Ahad732/PetCam/Hardware/production/bom.csv

Designator | Footprint | Quantity | Value | LCSC Part #
C1, C2 | 0402 | 2 | 10u
C3 | 0402 | 1 | 0.1u
D1 | 0402 | 1 | RED
D2 | 0402 | 1 | GREEN
J1 | PinSocket_2x09_P2.54mm_Vertical | 1 | Camera
J2 | USB_C_Receptacle_HCTL_HC-TYPE-C-16P-01A | 1 | USB_C_Receptacle_USB2.0_16P
J3 | microSD_HC_Molex_104031-0811 | 1 | Micro_SD_Card
J4 | PinSocket_1x02_P2.54mm_Vertical | 1 | Battery
J5, J6 | PinSocket_1x02_P2.54mm_Vertical | 2 | Conn_01x02_Pin
L1 | L_Vishay_IFSC-1515AH_4x4x1.8mm | 1 | 2.2u
R1, R2 | 0402 | 2 | 5.1k
R10, R11, R8 | 0402 | 3 | 1k
R3, R7 | 0402 | 2 | 10k
R4 | 0402 | 1 | 430k
R5 | 0402 | 1 | 100k
R6 | 0402 | 1 | 100
R9 | 0402 | 1 | 600
SW1 | SW_SPST_PTS810 | 1 | SW_Push
U1 | ESP32-S3-WROOM-1 | 1 | ESP32-S3-WROOM-1
U2 | VQFN-16-1EP_3x3mm_P0.5mm_EP1.6x1.6mm | 1 | BQ24072RGT
U3 | SOT-23-5 | 1 | TLV62568DBV
