Ahad732/PetCam/3d/case.step

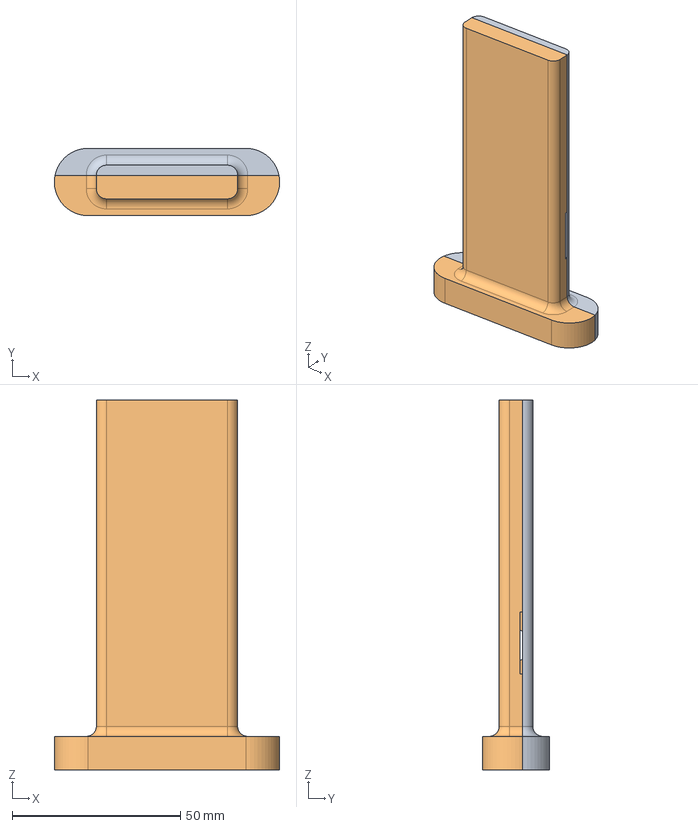
[picture p8: CAD file, 2026-11-08]
3d/case.step
67.0 x 20.0 x 110.0 mm
