Ahad732/PetCam/3d/Camera_OV5640_130deg.step

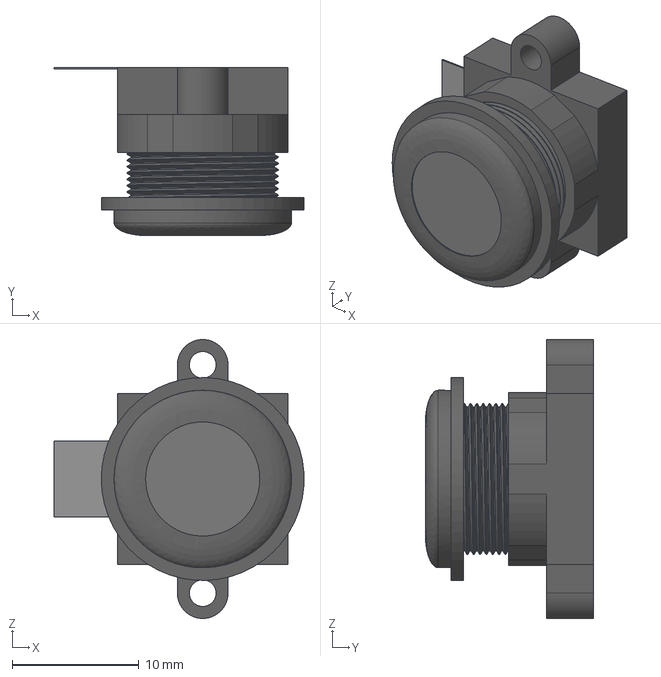
[picture p9: CAD file, 2026-11-08]
3d/Camera_OV5640_130deg.step
19.7 x 13.3 x 22.0 mm
