Ahad732/PetCam/3d/pcb.step

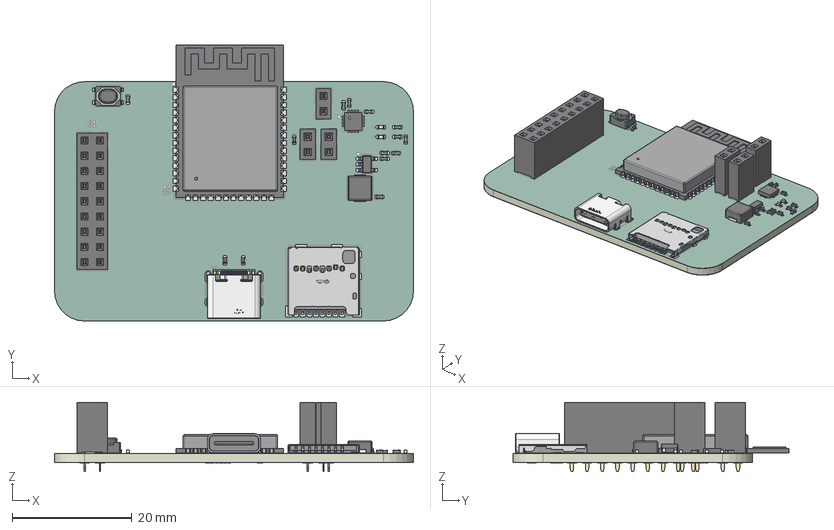
[picture p10: CAD file, 2026-11-08]
3d/pcb.step
60.0 x 46.1 x 11.6 mm
C_0402_1005Metric x 3
L_0402_1005Metric x 8
PinSocket_1x02_P2.54mm_Vertical x 3
R_0402_1005Metric x 3
SIM-SMD_8P-1040310811
LED_0402_1005Metric x 2
L_Vishay_IHLP-1616
TQFN_16_1EP_3x3mm_P05mm_EP16x16mm
SOT-23-5
SW_SPST_PTS810
USB-C-SMD_TYPE-C16PIN
PinSocket_2x09_P2.54mm_Vertical
ESP32-S3-WROOM-1
Pet2C7D_pad
Pet2C7D_silkscreen x 2
Pet2C7D_soldermask x 2
Pet2C7D_PCB
