Ahad732/PetCam/(list of files, cad)

Other CAD files:
3d/petcam-assembly.step
3d/case_printable.stl
