Ahad732/PetCam/media/schematic.pdf

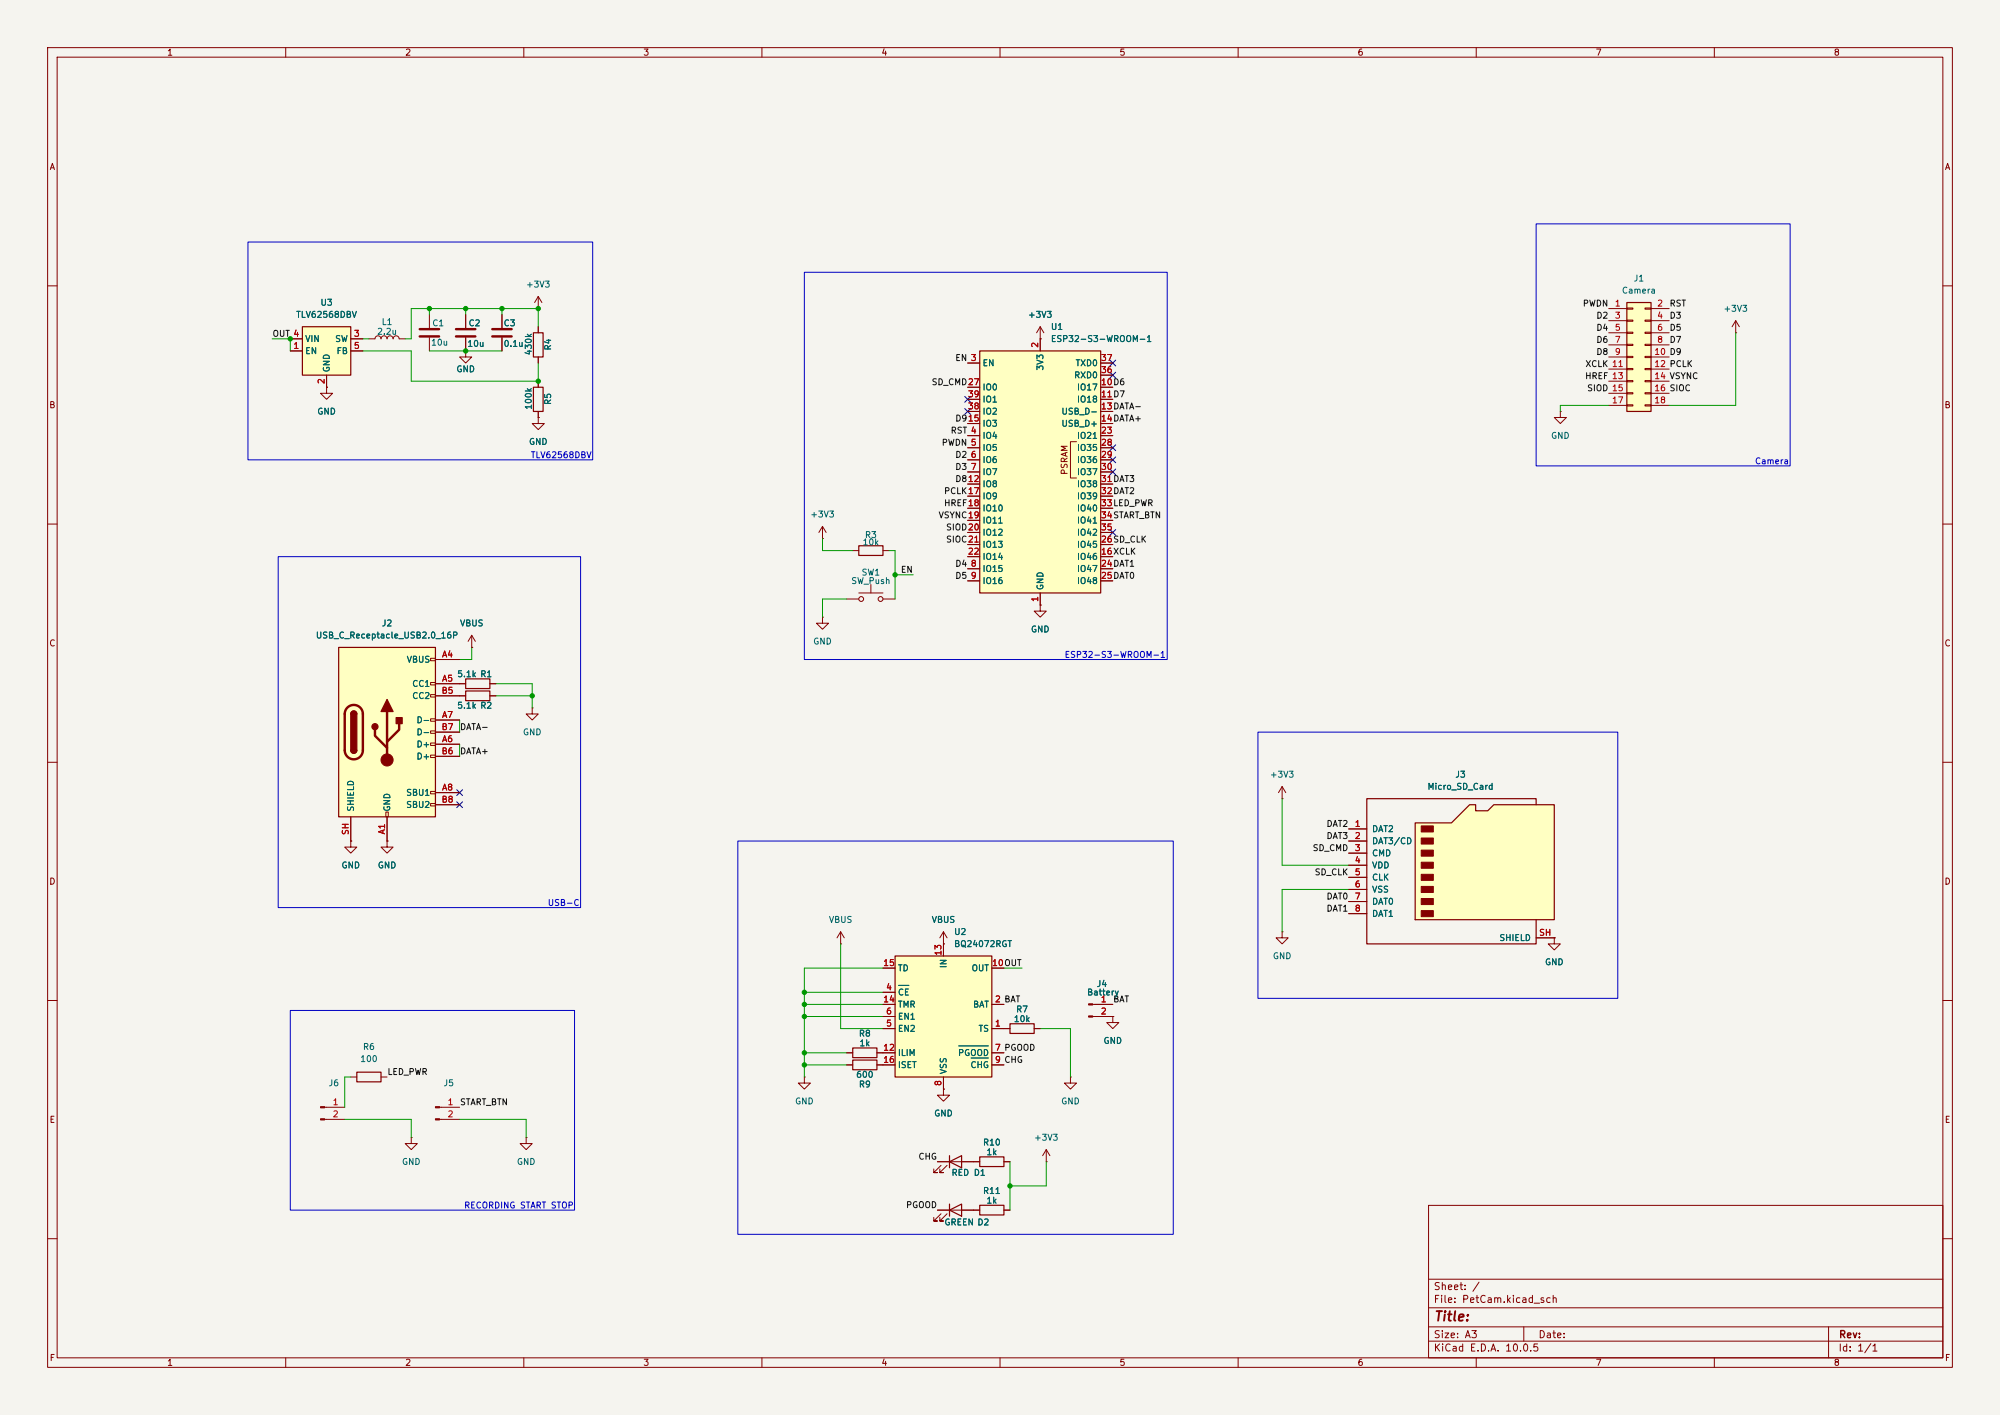
[picture p11: page 1]

Size: A3 | Rev:
KiCad E.D.A. 10.0.5 | Id: 1/1
