Ahad732/PetCam/Hardware/PetCam.kicad_pcb

## KiCad design Hardware/PetCam.kicad_pcb (2026-11-08)

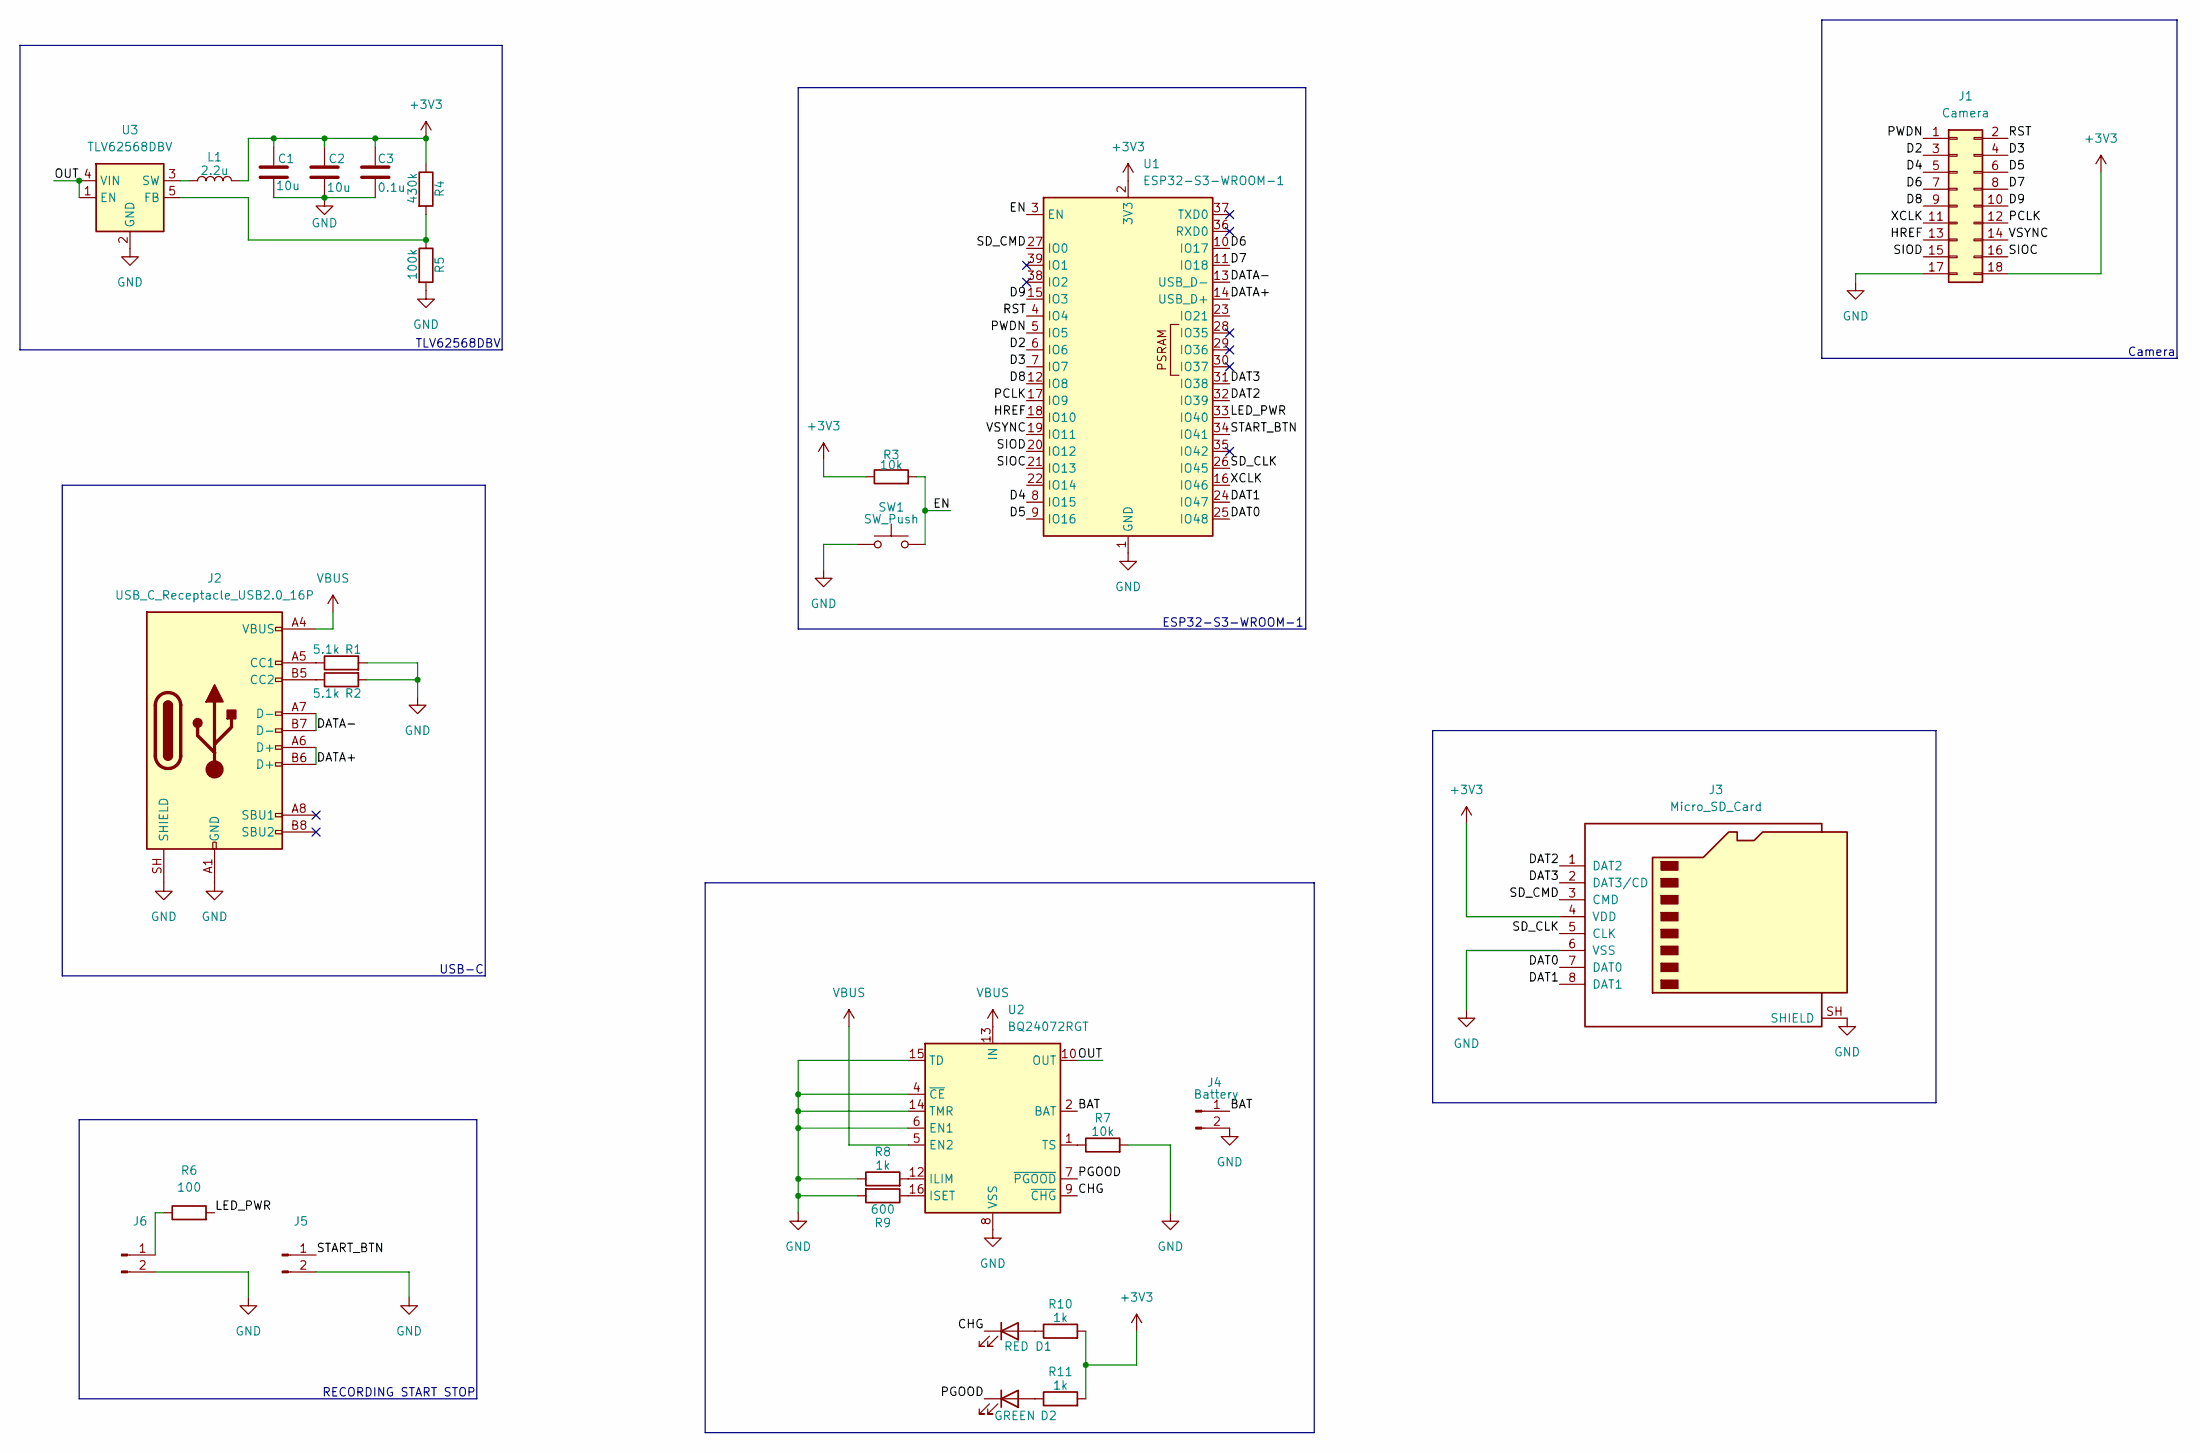
[picture p12: schematic PetCam.kicad_sch]

Parts:
C1, C2: 10u; C_0402_1005Metric
C3: 0.1u; C_0402_1005Metric
D1: RED; LED_0402_1005Metric
D2: GREEN; LED_0402_1005Metric
J1: Camera; PinSocket_2x09_P2.54mm_Vertical
J2: USB_C_Receptacle_USB2.0_16P; USB_C_Receptacle_HCTL_HC-TYPE-C-16P-01A
J3: Micro_SD_Card; microSD_HC_Molex_104031-0811
J4: Battery; PinSocket_1x02_P2.54mm_Vertical
J5, J6: Conn_01x02_Pin; PinSocket_1x02_P2.54mm_Vertical
L1: 2.2u; L_Vishay_IFSC-1515AH_4x4x1.8mm
R1, R2: 5.1k; R_0402_1005Metric
R3, R7: 10k; L_0402_1005Metric
R4: 430k; L_0402_1005Metric
R5: 100k; L_0402_1005Metric
R6: 100; R_0402_1005Metric
R8, R10, R11: 1k; L_0402_1005Metric
R9: 600; L_0402_1005Metric
SW1: SW_Push; SW_SPST_PTS810
U1: ESP32-S3-WROOM-1
U2: BQ24072RGT; VQFN-16-1EP_3x3mm_P0.5mm_EP1.6x1.6mm
U3: TLV62568DBV; SOT-23-5

Connections:
+3V3: C1.1, C2.1, C3.1, J1.18, J3.4 (VDD), L1.2, R3.1, R4.1, R10.2, R11.2, U1.2 (3V3)
/BAT: J4.1, U2.2 (BAT), U2.3 (BAT)
/CHG: D1.1 (K), U2.9 (~CHG)
/D2: J1.3, U1.6 (IO6)
/D3: J1.4, U1.7 (IO7)
/D4: J1.5, U1.8 (IO15)
/D5: J1.6, U1.9 (IO16)
/D6: J1.7, U1.10 (IO17)
/D7: J1.8, U1.11 (IO18)
/D8: J1.9, U1.12 (IO8)
/D9: J1.10, U1.15 (IO3)
/DAT0: J3.7 (DAT0), U1.25 (IO48)
/DAT1: J3.8 (DAT1), U1.24 (IO47)
/DAT2: J3.1 (DAT2), U1.32 (IO39)
/DAT3: J3.2 (DAT3/CD), U1.31 (IO38)
/DATA+: J2.A6 (D+), J2.B6 (D+), U1.14 (USB_D+)
/DATA-: J2.A7 (D-), J2.B7 (D-), U1.13 (USB_D-)
/EN: R3.2, SW1.2, U1.3 (EN)
/HREF: J1.13, U1.18 (IO10)
/LED_PWR: R6.2, U1.33 (IO40)
/OUT: U2.10 (OUT), U2.11 (OUT), U3.1 (EN), U3.4 (VIN)
/PCLK: J1.12, U1.17 (IO9)
/PGOOD: D2.1 (K), U2.7 (~PGOOD)
/PWDN: J1.1, U1.5 (IO5)
/RST: J1.2, U1.4 (IO4)
/SD_CLK: J3.5 (CLK), U1.26 (IO45)
/SD_CMD: J3.3 (CMD), U1.27 (IO0)
/SIOC: J1.16, U1.21 (IO13)
/SIOD: J1.15, U1.20 (IO12)
/START_BTN: J5.1, U1.34 (IO41)
/VSYNC: J1.14, U1.19 (IO11)
/XCLK: J1.11, U1.16 (IO46)
GND: C1.2, C2.2, C3.2, J1.17, J2.A1 (GND), J2.A12 (GND), J2.B1 (GND), J2.B12 (GND), J2.SH (SHIELD), J3.6 (VSS), J3.SH (SHIELD), J4.2, J5.2, J6.2, R1.2, R2.2, R5.2, R7.2, R8.1, R9.2, SW1.1, U1.1 (GND), U1.40 (GND), U1.41 (GND), U2.4 (~CE), U2.6 (EN1), U2.8 (VSS), U2.14 (TMR), U2.15 (TD), U2.17 (VSS), U3.2 (GND)
unnamed: D1.2 (A), R10.1
unnamed: D2.2 (A), R11.1
unnamed: J2.A5 (CC1), R1.1
unnamed: J2.B5 (CC2), R2.1
unnamed: J6.1, R6.1
unnamed: R8.2, U2.12 (ILIM)
unnamed: R9.1, U2.16 (ISET)
unnamed: R7.1, U2.1 (TS)
unnamed: R4.2, R5.1, U3.5 (FB)
unnamed: L1.1, U3.3 (SW)
VBUS: J2.A4 (VBUS), J2.A9 (VBUS), J2.B4 (VBUS), J2.B9 (VBUS), U2.5 (EN2), U2.13 (IN)

Notes on the sheet:
Camera
TLV62568DBV
ESP32-S3-WROOM-1
RECORDING START STOP
USB-C

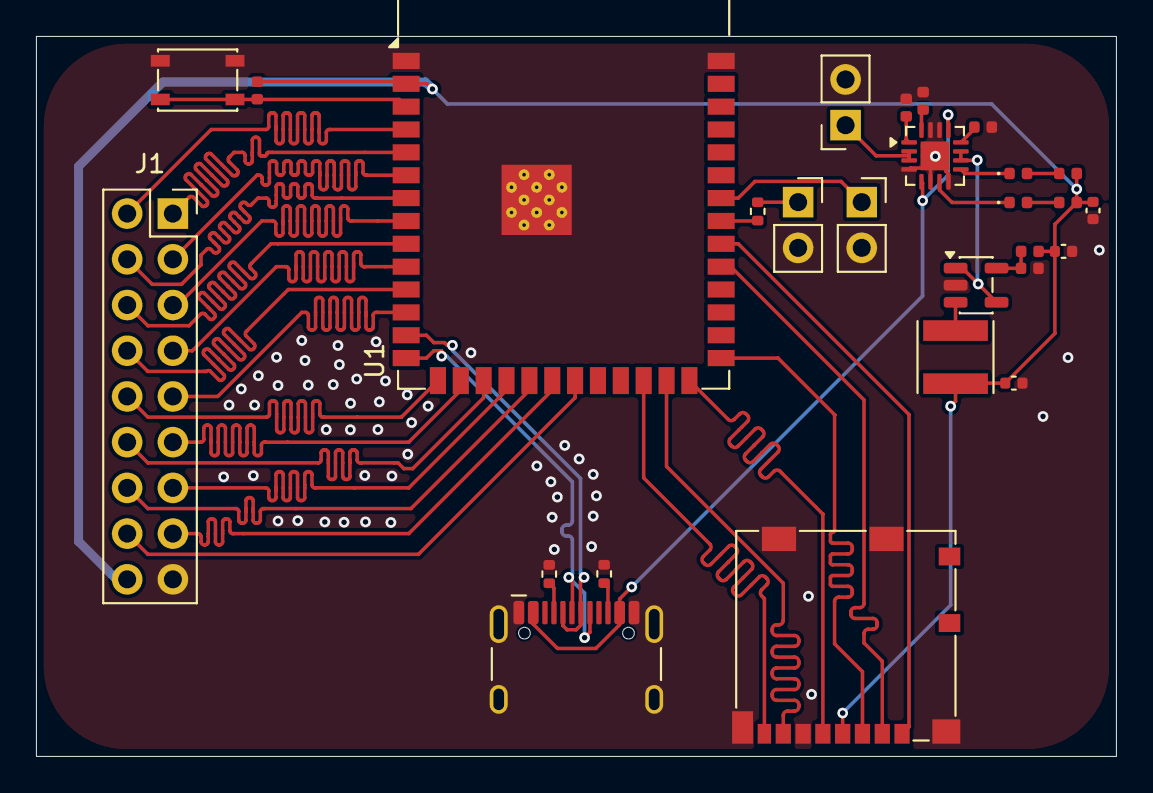
[picture p13: board PetCam.kicad_pcb from above]

Board: 2 copper layers, 60.0 x 40.0 mm, 27 parts (0 on the bottom side), 44 nets.
