Ahad732/PetCam/Journal-Keyaan.md

# Nov 8 2026

Okay so i started with the PCB, added some art, added my beloved meme of larry, and then i did proper via stiching and all that stuff. The final version of the PCB looks like this:  
3d-pcb-front  
3d-pcb-back    

After all that was done, i searched for the waveshare ov5640 model, which was no where to be found, so i just made a bare PCB, and put the OV5640 camera model on it, as that works too, no sites like grabcad or snapeda had it, they should atleast provide it man, not even adafruit :/
Mine:  
  
Waveshare's:  
  

I also exported the PCB from the KiCAD PCB editor and then put it into Onshape!

## Session 2

I am trying to model a teddy bear-like shape, because that seems really cool for this kind of enclosure!  
I've been trying to make a small cute teddy bear like architecture, but i am failing miserably at it, so i am gonna try some other form of doing it, this is what it looks like:  
  

Okay so i did something something, and made this sleek case, it took a lot of efforts to make this, but yeah, i actualy made it!!  
case  

Well that is all the work that i did!  
every time i do CAD i realise how bad i am at CAD, it makes me sad sometimes ://  

Anyways, I wrote the readme by hand and also screenshotted and added the images, whoops, gotta add the BOM too!
Added the BOM, generated latest prod files, and i am done with this project!!
