Ahad732/PetCam/(commit log)

2026-11-06 startedf PCB after research
    [PetCam.kicad_pcb, PetCam.kicad_sch]
2026-11-07 Completed research and most of the schematic
    [PetCam.kicad_pcb, PetCam.kicad_sch]
2026-11-07 restarted layout
    [PetCam.kicad_pcb, PetCam.kicad_sch]
2026-11-07 Completed PCB
    [PetCam.kicad_pcb, PetCam.kicad_sch]
2026-11-08 wrote journal and revised pcb layout
    [PetCam.kicad_pcb]
2026-11-08 Added production files
    [PetCam.kicad_pcb, bom.csv, designators.csv, positions.csv]
2026-11-08 added BOM
    [BOM.csv]
2026-11-08 added Journal, and 3d model
    [PetCam-pcb.step]
2026-11-08 Revised PCB
    [PetCam.kicad_pcb, PetCam.kicad_sch]
2026-11-08 made schematic page size smaller
    [PetCam.kicad_sch]
2026-11-08 moved the BOM to root
    [BOM.csv]
2026-11-08 added latest production files and 3d models and printable STLs
    [BOM.csv, Camera_OV5640_130deg.step, PetCam.kicad_pcb, case.step, case_printable.stl, pcb.step, petcam-assembly.step]
